SgtMilk/SFInnovation/react-ui/src/help/manualVentilation.jpg

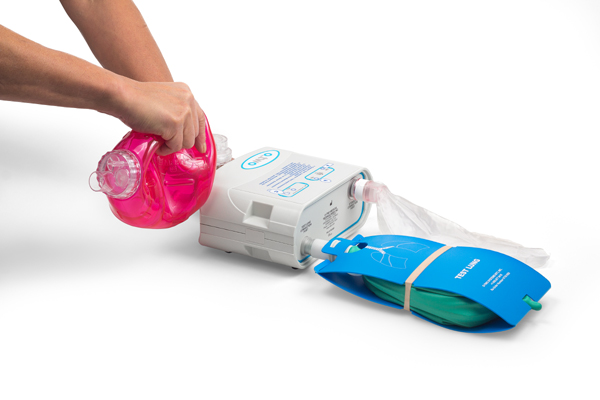
react-ui/src/help/manualVentilation.jpg
