SgtMilk/SFInnovation/Note for the code.pdf

Please consult the Assembly protocol and operational manual files provided as well as the following Github repository: https://github.com/ilangleben19/SFVentilator .

All informations required by this section are in these files.
