SgtMilk/SFInnovation/P&ID SFInnovations.pdf

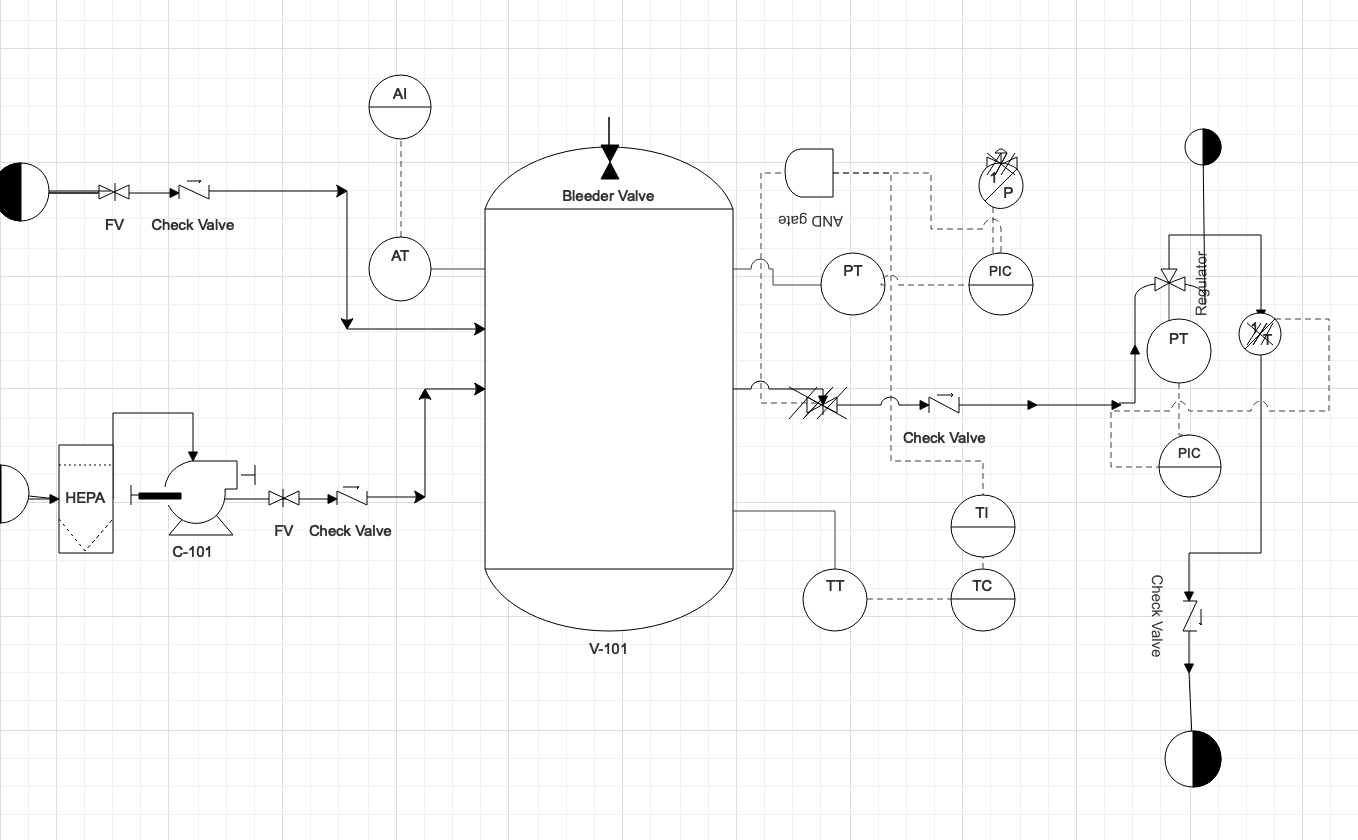
[picture p2: page 1]
