SgtMilk/SFInnovation/Respirator_Arduino_I2C_bb.pdf

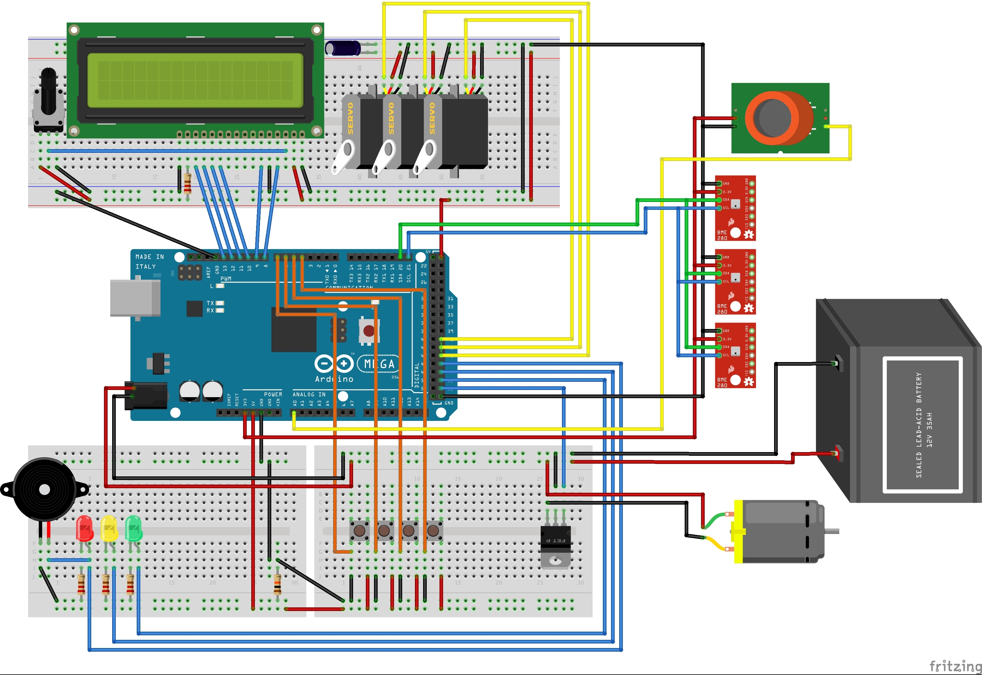
[picture p3: page 1]
