SgtMilk/SFInnovation/Respirator_Arduino_I2C_schem.pdf

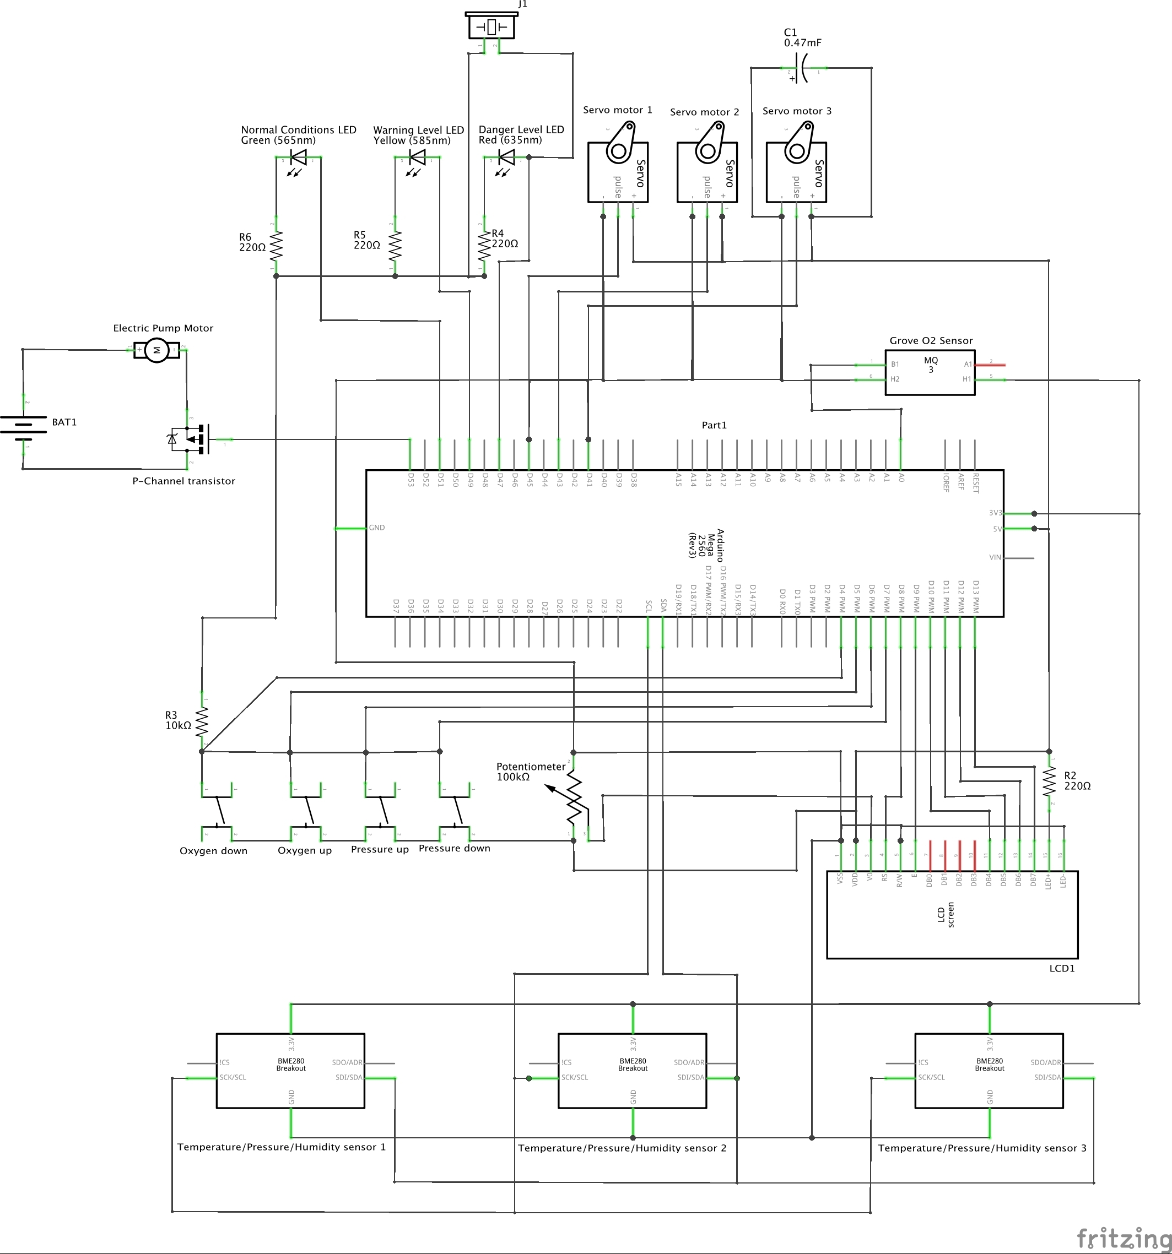
[picture p4: page 1]
