SgtMilk/SFInnovation/react-ui/src/help/alarmDialog.png

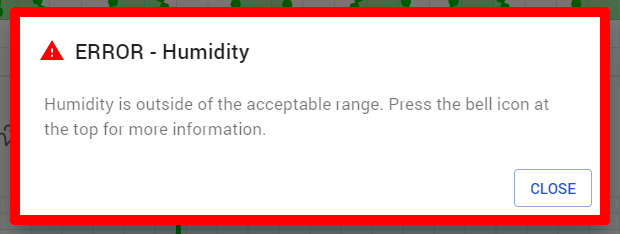
react-ui/src/help/alarmDialog.png
