SgtMilk/SFInnovation/react-ui/src/help/alarmMenu.png

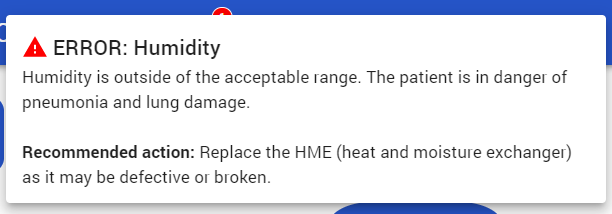
react-ui/src/help/alarmMenu.png
