SgtMilk/SFInnovation/react-ui/src/help/DesFiO2.png

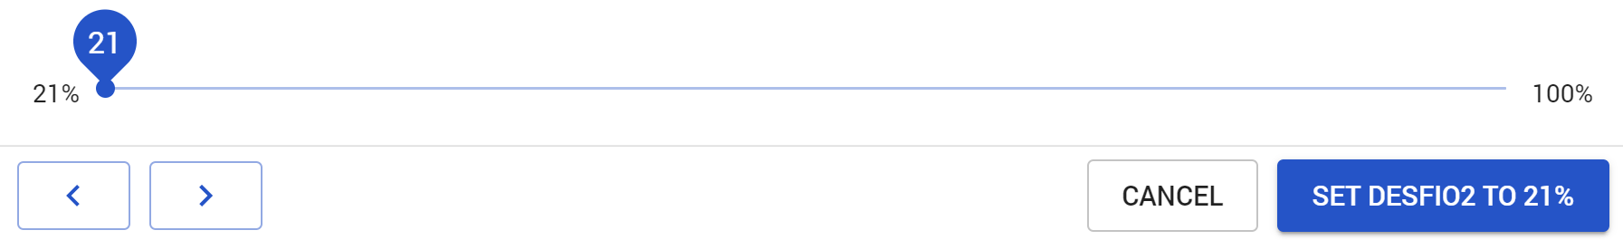
react-ui/src/help/DesFiO2.png
