SgtMilk/SFInnovation/react-ui/src/help/Pmax.png

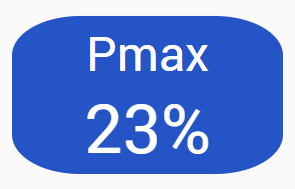
react-ui/src/help/Pmax.png
