SgtMilk/SFInnovation/react-ui/src/help/Pmin.png

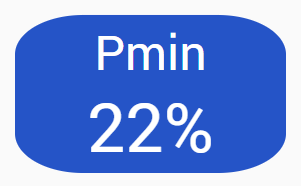
react-ui/src/help/Pmin.png
