SgtMilk/SFInnovation/react-ui/src/help/RoomTemp.png

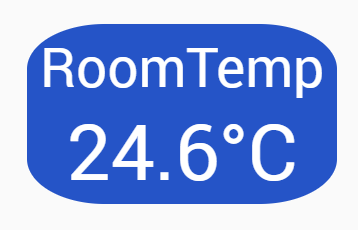
react-ui/src/help/RoomTemp.png
