SgtMilk/SFInnovation/react-ui/src/help/RR.png

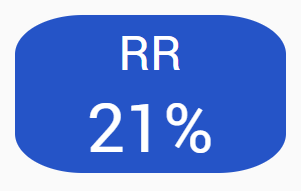
react-ui/src/help/RR.png
