SgtMilk/SFInnovation/react-ui/src/help/VT.png

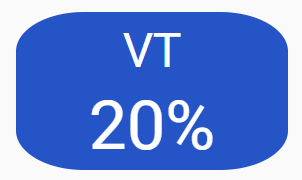
react-ui/src/help/VT.png
