SgtMilk/SFInnovation/react-ui/src/help/wallSocket.png

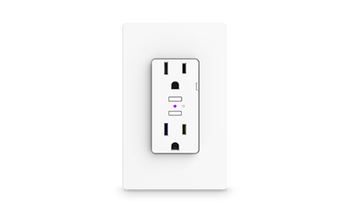
react-ui/src/help/wallSocket.png
